JoseAvalos/JRO-/doc/trunk/ddsroot/docs/datasheets/mcu_k64f/FRDM-K64F.jpg

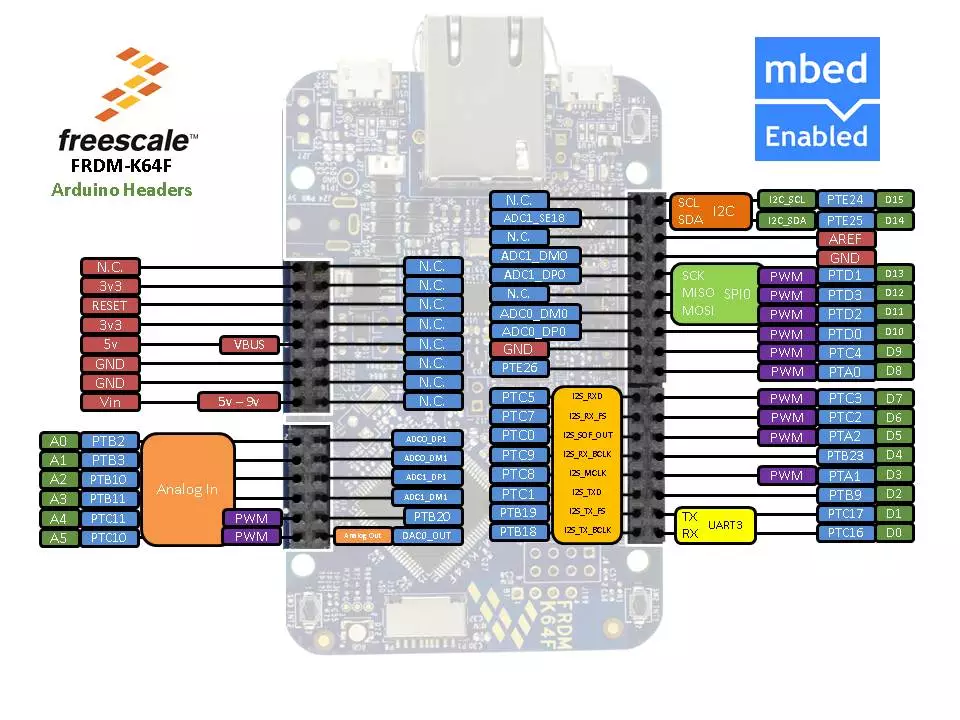
doc/trunk/ddsroot/docs/datasheets/mcu_k64f/FRDM-K64F.jpg
