JoseAvalos/JRO-/doc/trunk/ddsroot/source/schematics/dds_ad9854/README

JRO EVM AD9854

Esta tarjeta fue desarrollado en Jicamarca y esta basada integramente en la tarjeta de evaluacion 
del AD9854. El programa para su diseno fue Orcad (en el ano 2011)
