JoseAvalos/JRO-/doc/DDS_block_diagram.png

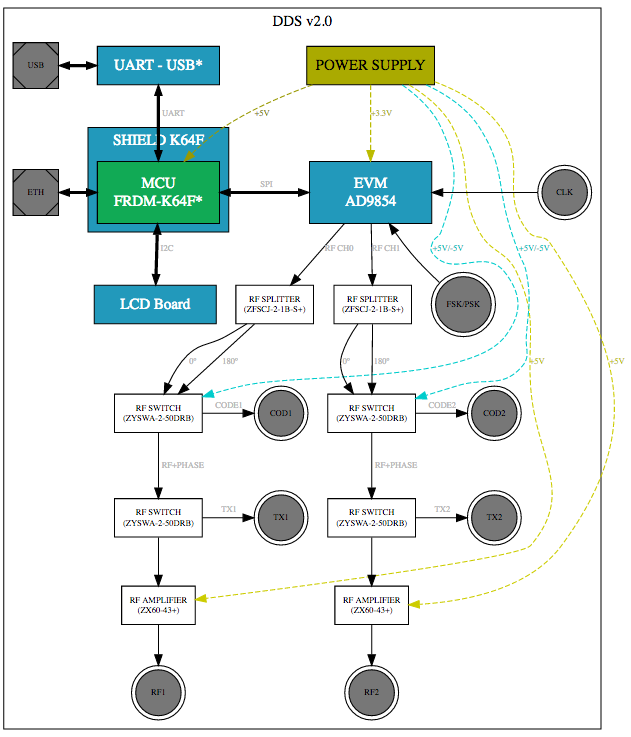
doc/DDS_block_diagram.png
