JoseAvalos/JRO-/doc/trunk/ddsroot/source/schematics/usb_serial/gerber/RC_USB1-BOM.txt

Item	Cantidad	Referencia	Descripción			Código
1	3		C1,C2,C3	Condensador 100nF, 0805		378
2	1		C4		Condensador 10uF, 3528		359
3	1		IC1		Circuito Integrado FT 232RL	807
4	1		X1		Conector USB tipo B		3168
5	1		X2		Header 2x5 para PCB, macho	1010
