JoseAvalos/JRO-/doc/trunk/ddsroot/source/schematics/dds_ad9854/gerber/DDS-BOM.xls

DDS 4 CAPAS
Item | Cantidad | Referencia | Descripción | Código Almacen | Donación
1 | 3 | C1,C2, C45 | Condensador 10nF, 50V, 1206 |  | PCF1308CT-ND | F
2 | 2 | C4, C37 | Condensador 27pF, 50V, 0805 | 385
3 | 2 | C5, C38 | Condensador 47pF, 50V, 0805 | 387
4 | 2 | C25, C6 | Condensador 10uF, 10V, 3528 | 359 |  | X
5 | 12 | C7, C9 ,C10, C11, C12, C13, C22, C23, C24, C27, C29, C44 | Condensador 0.1uF, 10V, 0402 | 354 |  | X
6 | 2 | C30, C39 | Condensador 39pF, 50V, 0805 | 386
7 | 2 | C31, C40 | Condensador 22pF, 50V, 0805 | 384
8 | 2 | C32, C41 | Condensador 2.2pF, 50V, 1206 | 382
9 | 2 | C33, C42 | Condensador 12pF, 50V, 0805 | 381
10 | 2 | C43, C34 | Condensador 8.2pF, 50V, 1206 | 388
11 | 5 | J1, J6, J7,J25, J26 | Conector SMA para PCB, 90°, 5mm | 953 |  | X
12 | 2 | J4, J5 | Conector SMA para PCB, 0°, 5mm |  | ACX1230-ND | X
13 | 1 | J10 | IDC header macho 2x20 PCB | 1008 |  | X
14 | 4 | L1, L2, L3, L5 | Inductancia 68 nH, 1008 | 1553 |  |  | X
15 | 2 | L6, L4 | Inductancia 82 nH, 1008 | 3457 |  |  | X
16 | 6 | R1, R5, R6, R11, R12, R13 | Resistencia de 49.9, 1206 | 2289 |  | X
17 | 2 | R20, R2 | Resistencia de 3.92K, 1206 | 2319 |  | X
18 | 2 | R3, R7 | Resistencia de 24.9, 0805 |  | PAT25.0BCT-ND | X
19 | 1 | R4 | Resistencia de 1.3K, 1206 |  | P1.30KFCT-ND | X
20 | 1 | R8 | Resistencia de 2K, 1206 | 2316 |  | X
21 | 2 | R10, R9 | Resistencia de 100, 1206 | 2293 |  | X
22 | 2 | R19, R14 | Resistencia de 0 ohmios, 0603 | 3579 |  | X
23 | 2 | TB1 | Bornera PCB 2 pines | 148 |  | X
24 | 1 | U1 | Circuito integrado AD9854AST | 705 |  | X
25 | 1 | U3 | Circuito Integrado MC100LVEL | 473 |  |  | X
26 | 5 | W1, W2, W3, W4, W8 | Espadín 3 pines | 996 |  | X
27 | 2 | W6, W16 | Espadín 2 pines | 996 |  | X
28 | 1 |  | Disipador de temperatura 15mm x 15mm x 9mm | 3583 |  | X
