JoseAvalos/JRO-/test/log10.png

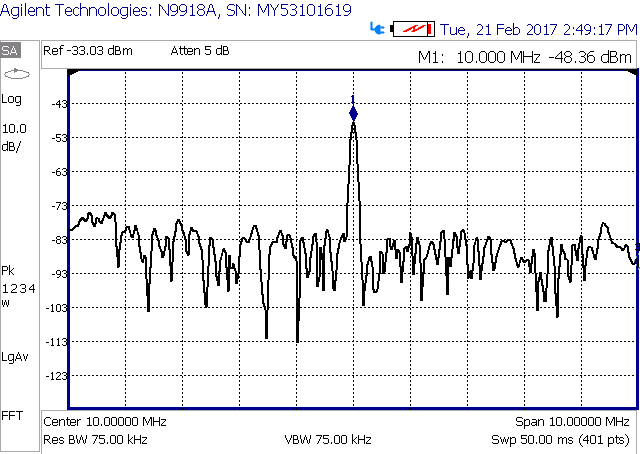
test/log10.png
