JoseAvalos/JRO-/test/log20.png

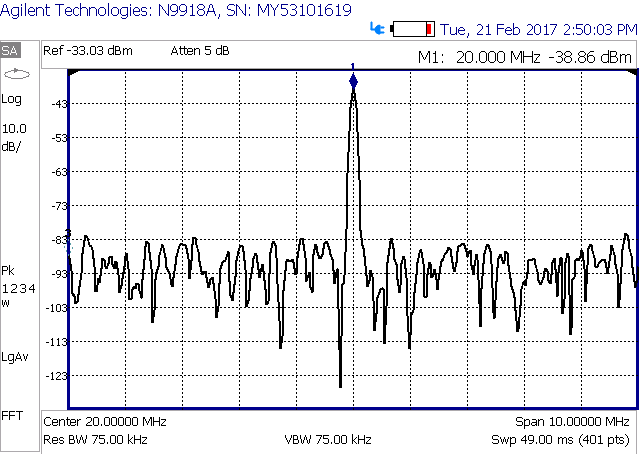
test/log20.png
