JoseAvalos/JRO-/test/log30.png

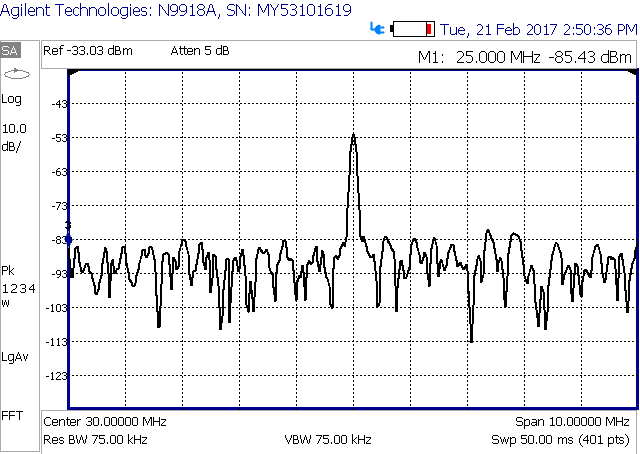
test/log30.png
