JoseAvalos/JRO-/test/log40.png

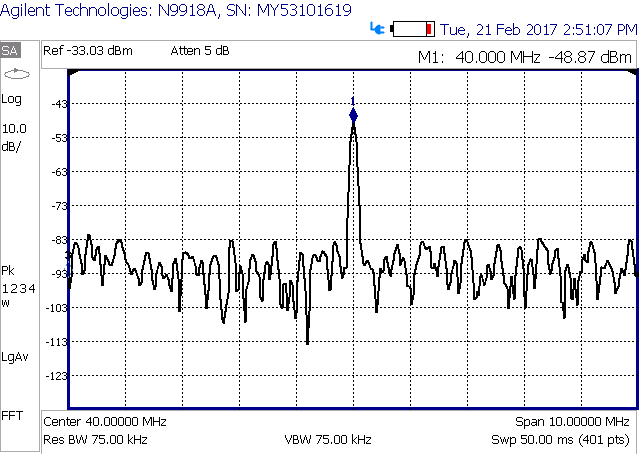
test/log40.png
