JoseAvalos/JRO-/test/log49.920.png

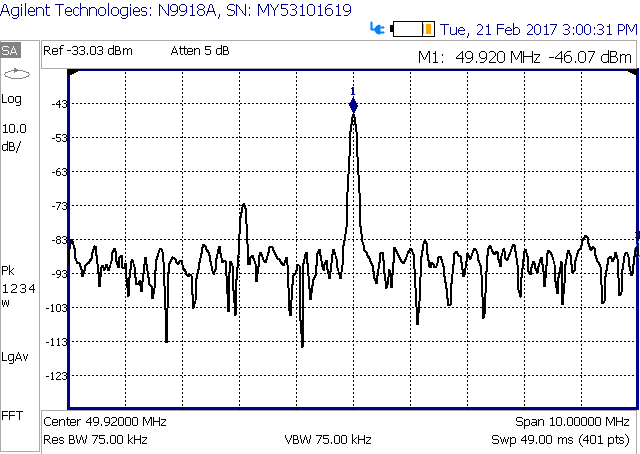
test/log49.920.png
