JoseAvalos/JRO-/test/log50.png

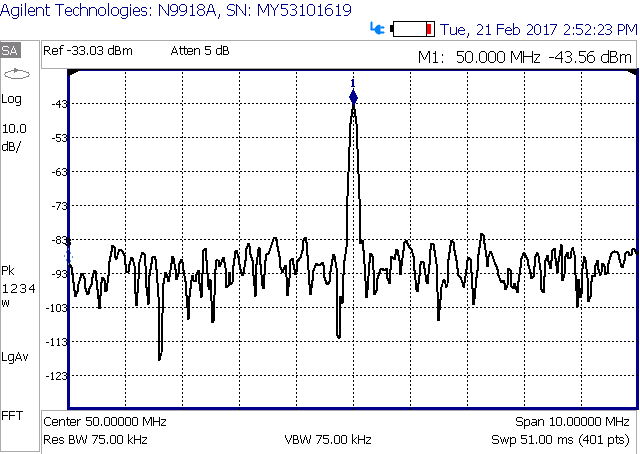
test/log50.png
