JoseAvalos/JRO-/test/log60.png

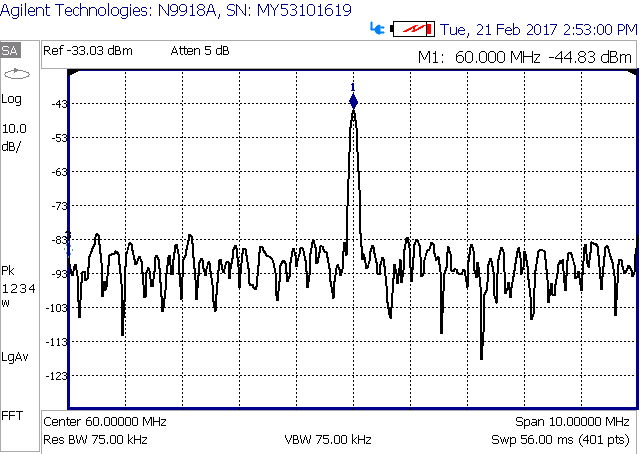
test/log60.png
