JoseAvalos/JRO-/test/log70.png

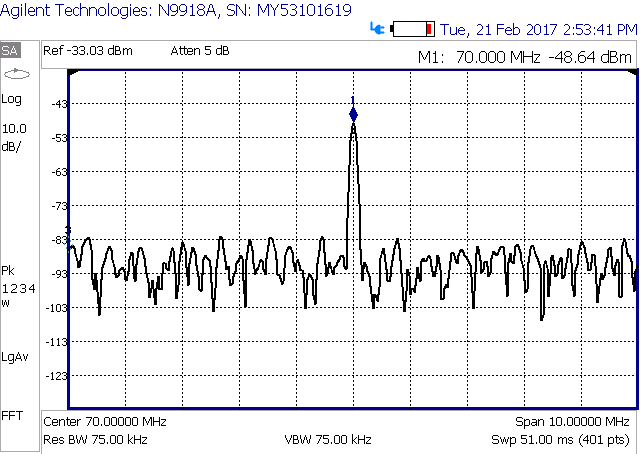
test/log70.png
