JoseAvalos/JRO-/test/log90.png

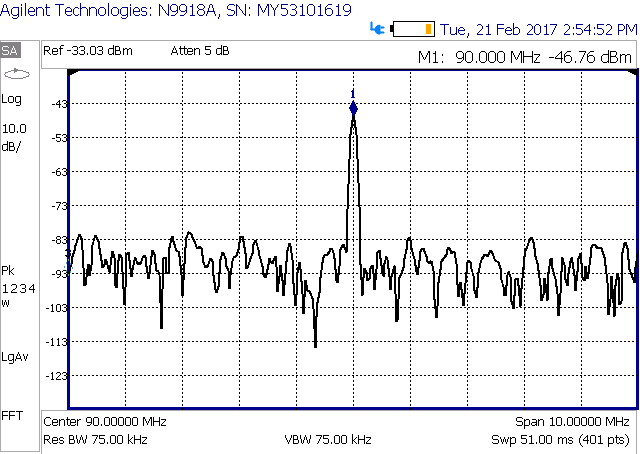
test/log90.png
