JoseAvalos/JRO-/test/log100.png

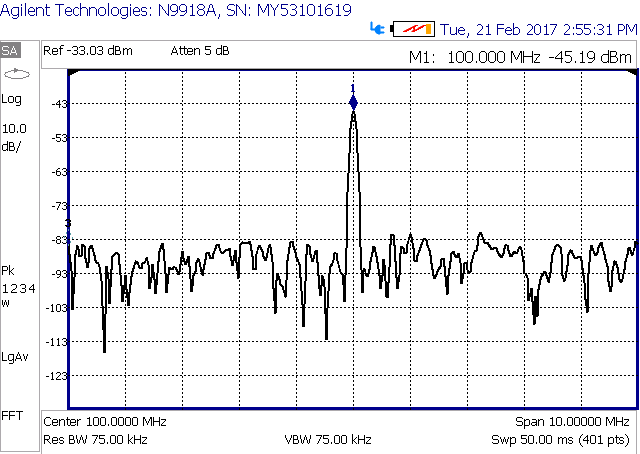
test/log100.png
