JoseAvalos/JRO-/test/log110.png

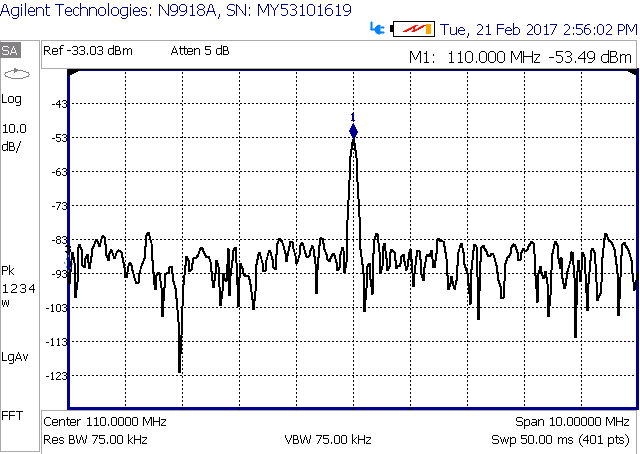
test/log110.png
