JoseAvalos/JRO-/test/log120.png

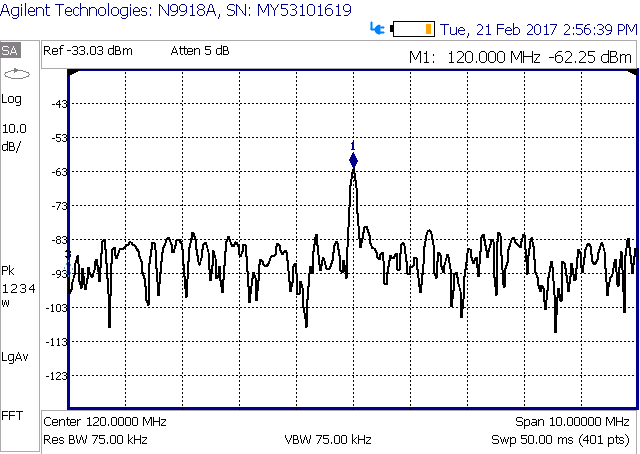
test/log120.png
