JoseAvalos/JRO-/doc/trunk/ddsroot/source/schematics/dds_ad9854/DDS0-SCH.pdf

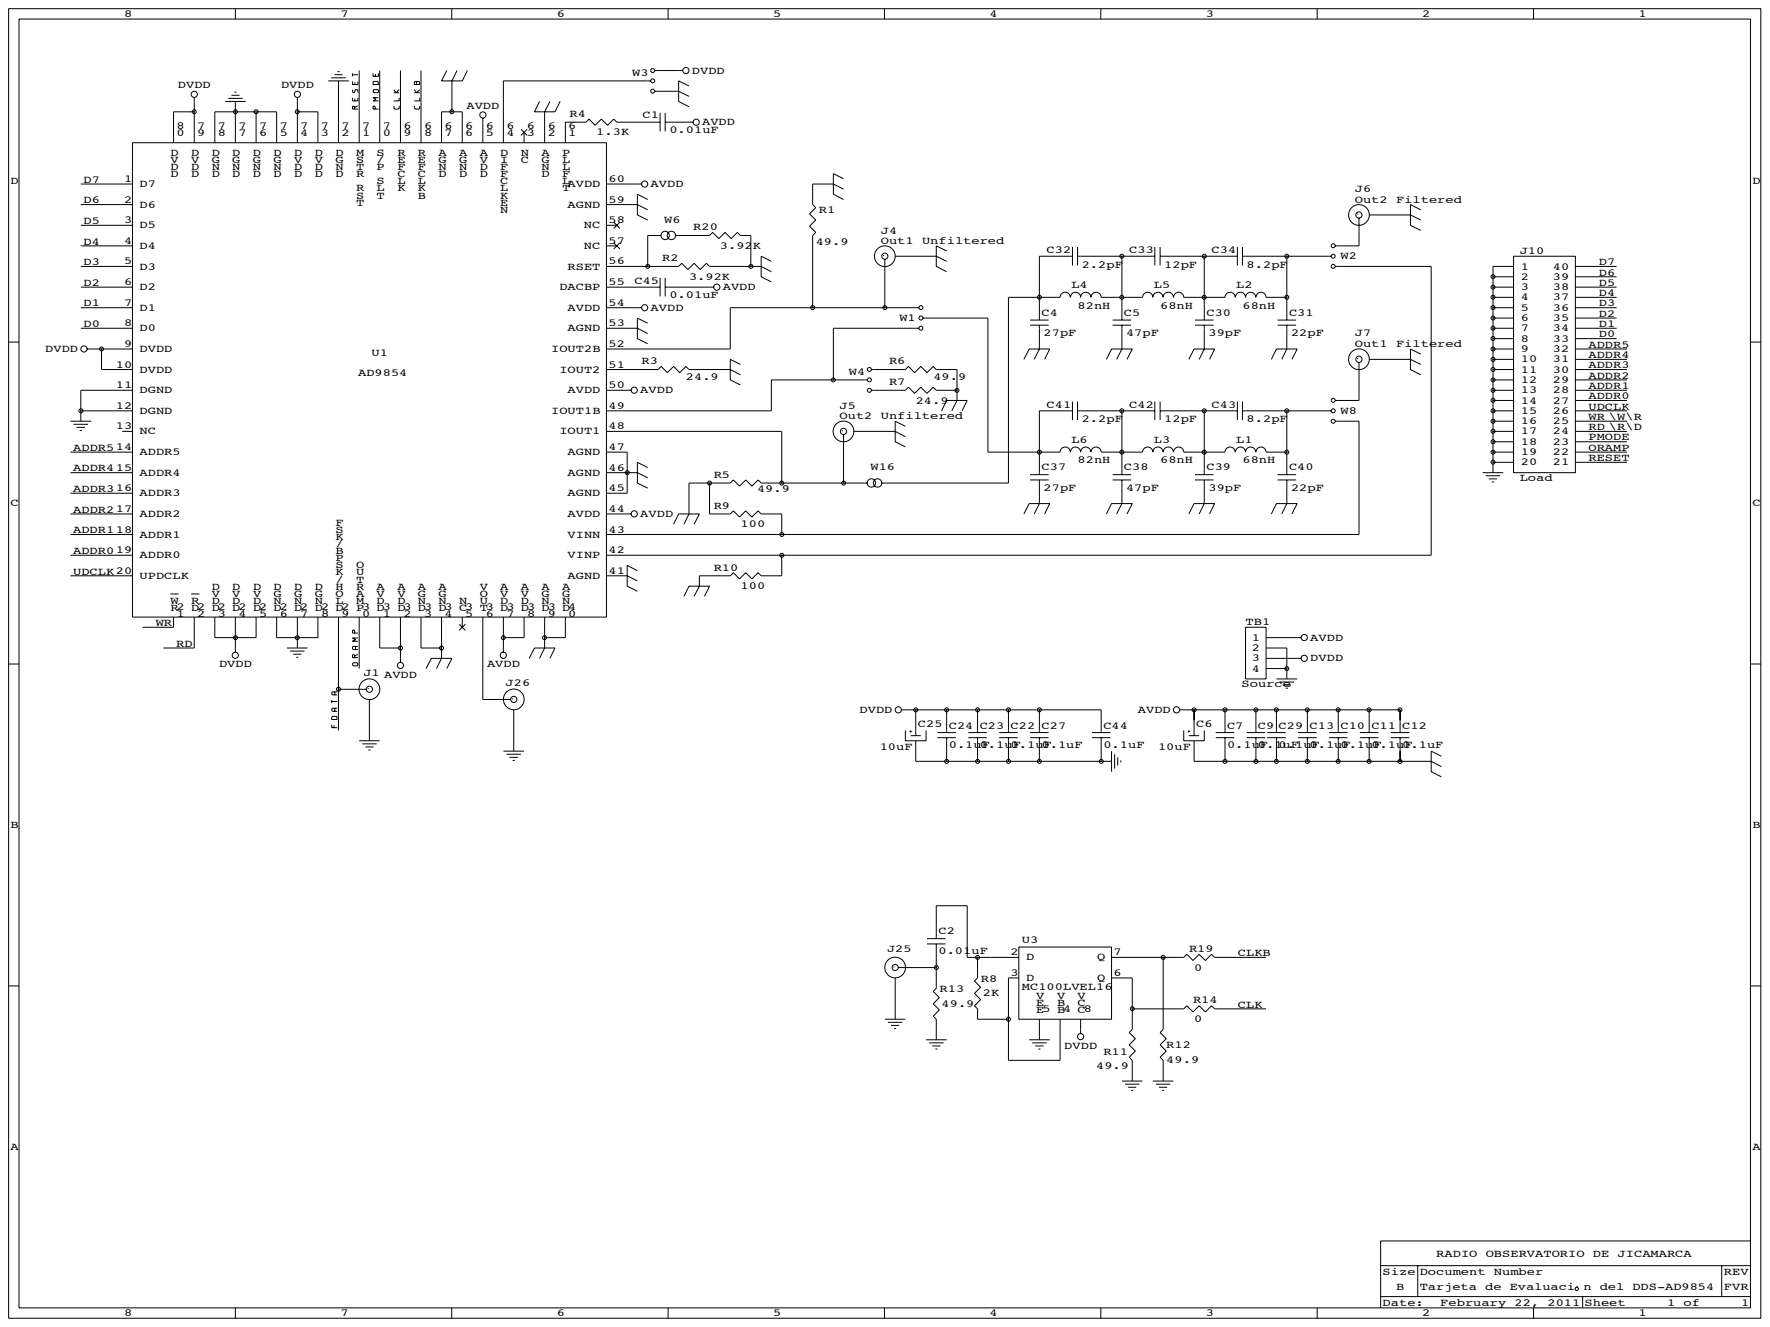
[picture p15: page 1]

RADIO OBSERVATORIO DE JICAMARCA
