JoseAvalos/JRO-/doc/trunk/ddsroot/source/schematics/shield_mcu_dds/SHIELD_MCU_DDS_1_3.brd

## EAGLE design doc/trunk/ddsroot/source/schematics/shield_mcu_dds/SHIELD_MCU_DDS_1_3.brd (2017-03-01)

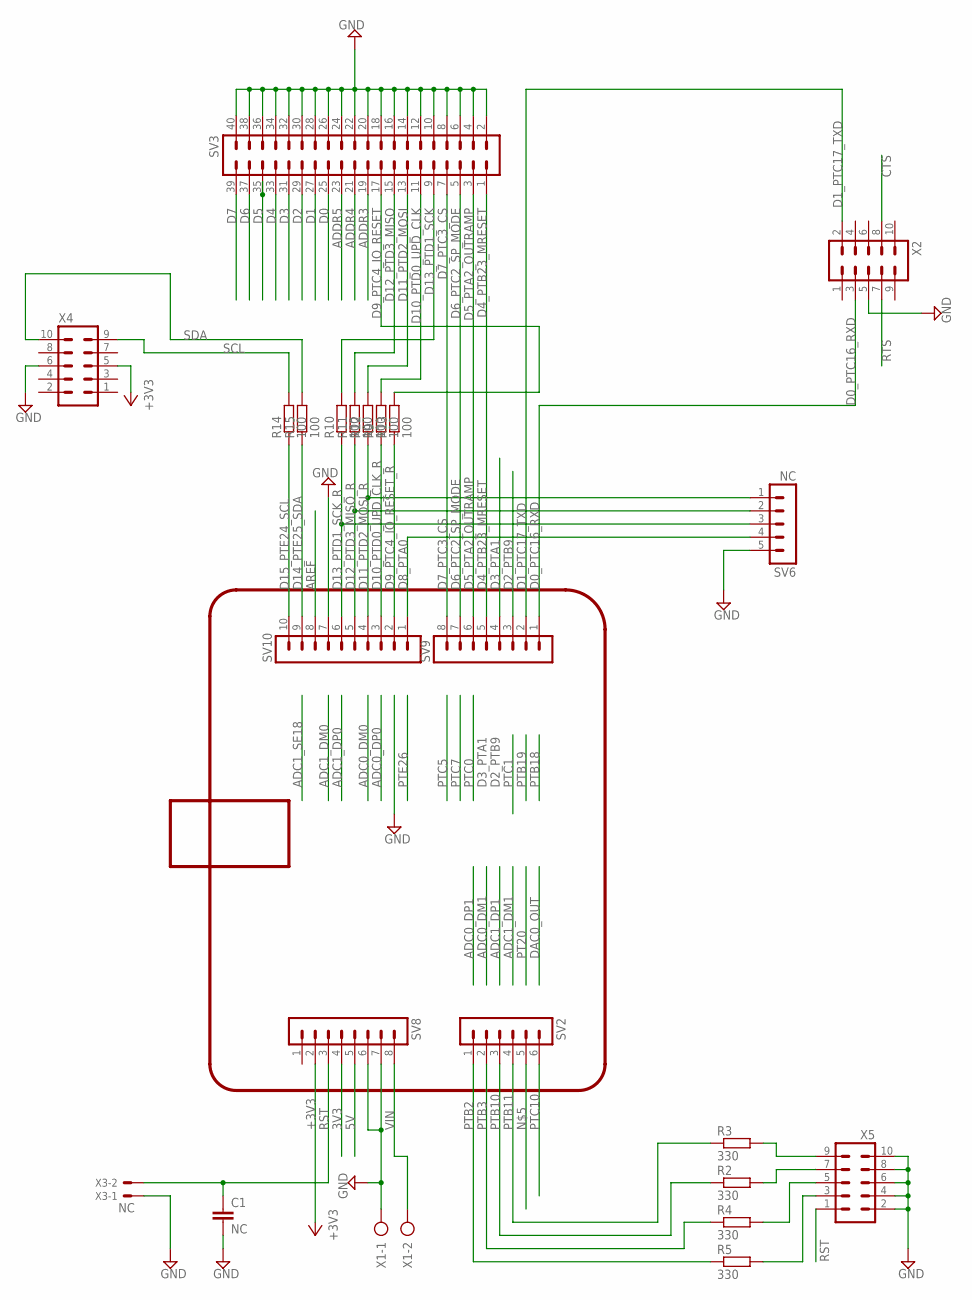
[picture p16: schematic SHIELD_MCU_DDS_1_3.sch]

Parts:
C1: NC; C1206
R2, R3, R4, R5: 330; R0603
R9, R10, R11, R12, R13, R14, R15: 100; 0204/7
SV2: MA06-1
SV3: ML40
SV6: NC; MA05-1
SV8, SV9: MA08-1
SV10: MA10-1
X1: AK300/2
X2, X4, X5: ML10
X3: NC; 22-23-2021

Connections:
3V3: SV8.4
5V: SV8.5
+3V3: SV8.2, X4.5
ADDR3: SV3.19
ADDR4: SV3.21
ADDR5: SV3.23
AREF: SV10.8
CTS: X2.8
D0: SV3.25
D0_PTC16_RXD: SV9.1, X2.3
D1: SV3.27
D1_PTC17_TXD: SV9.2, X2.2
D2: SV3.29
D2_PTB9: SV9.3
D3: SV3.31
D3_PTA1: SV9.4
D4: SV3.33
D4_PTB23_MRESET: SV3.1, SV9.5
D5: SV3.35
D5_PTA2_OUTRAMP: SV3.3, SV9.6
D6: SV3.37
D6_PTC2_SP_MODE: SV3.5, SV9.7
D7: SV3.39
D7_PTC3_CS: SV3.7, SV9.8
D8_PTA0: SV6.4, SV10.1
D9_PTC4_IO_RESET: R13.2, SV3.17
D9_PTC4_IO_RESET_R: R13.1, SV10.2
D10_PTD0_UPD_CLK: R9.2, SV3.11
D10_PTD0_UPD_CLK_R: R9.1, SV10.3
D11_PTD2_MOSI: R12.2, SV3.13
D11_PTD2_MOSI_R: R12.1, SV6.1, SV10.4
D12_PTD3_MISO: R11.2, SV3.15
D12_PTD3_MISO_R: R11.1, SV6.2, SV10.5
D13_PTD1_SCK: R10.2, SV3.9
D13_PTD1_SCK_R: R10.1, SV6.3, SV10.6
D14_PTE25_SDA: R15.1, SV10.9
D15_PTE24_SCL: R14.1, SV10.10
GND: C1.2, SV3.2, SV3.4, SV3.6, SV3.8, SV3.10, SV3.12, SV3.14, SV3.16, SV3.18, SV3.20, SV3.22, SV3.24, SV3.26, SV3.28, SV3.30, SV3.32, SV3.34, SV3.36, SV3.38, SV3.40, SV6.5, SV8.6, SV8.7, SV10.7, X1.1, X2.5, X3.1, X4.6, X5.2, X5.4, X5.6, X5.8, X5.10
unnamed: R2.2, X5.7
unnamed: R4.2, X5.5
unnamed: R5.2, X5.3
unnamed: R3.2, X5.9
PTB2: R5.1, SV2.1
PTB3: R4.1, SV2.2
PTB10: R2.1, SV2.3
PTB11: R3.1, SV2.4
PTC10: SV2.6
RST: C1.1, SV8.3, X3.2, X5.1
RTS: X2.7
SCL: R14.2, X4.9
SDA: R15.2, X4.10
VIN: SV8.8, X1.2

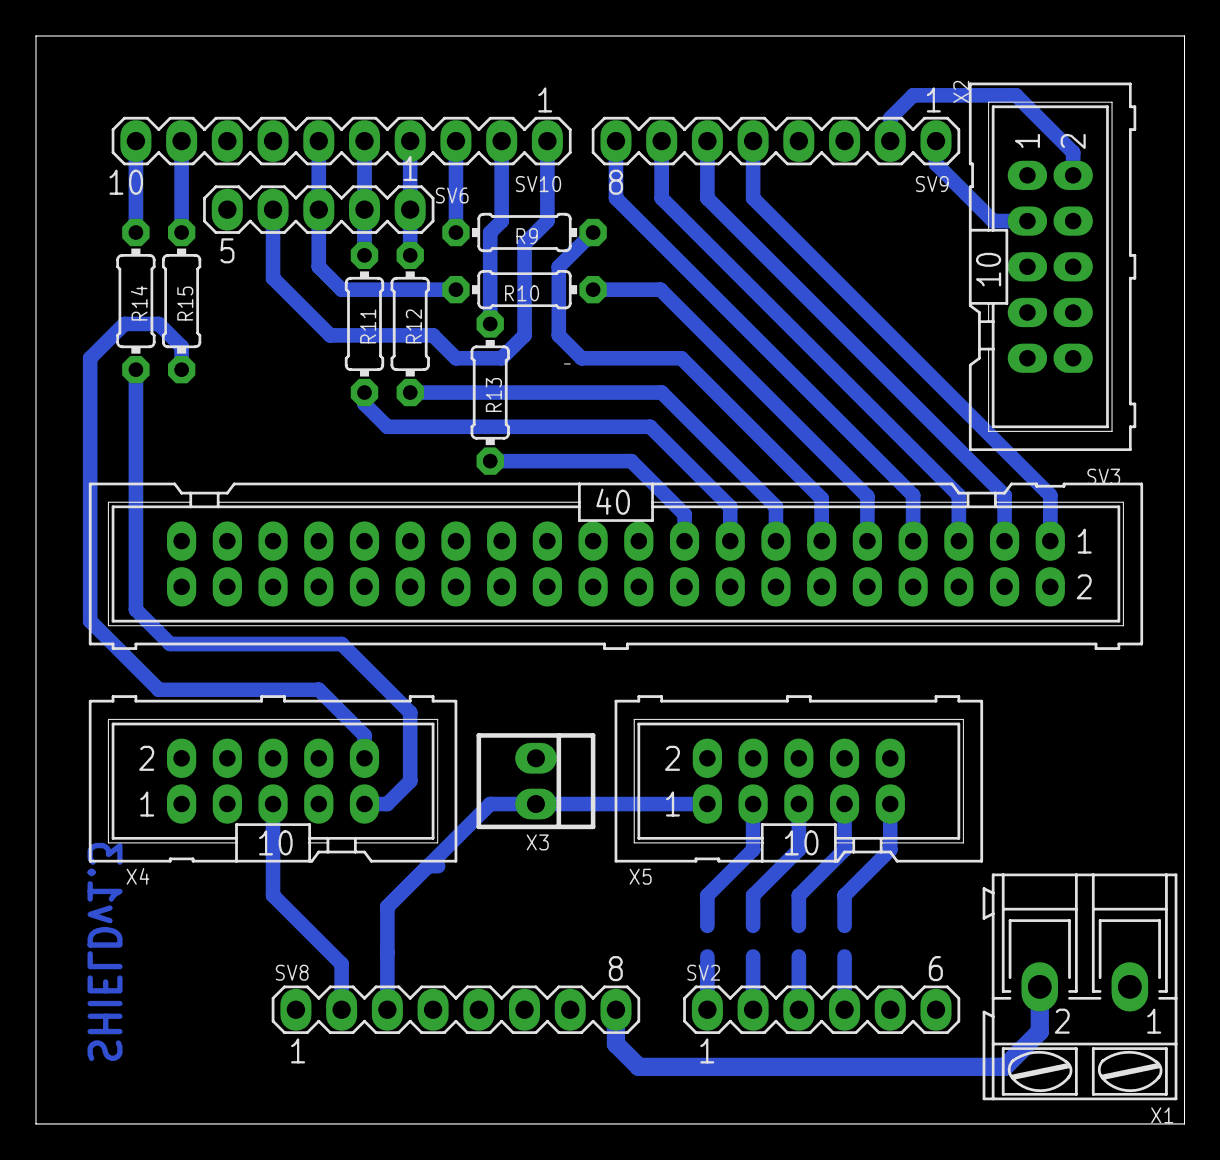
[picture p17: board SHIELD_MCU_DDS_1_3.brd from above]

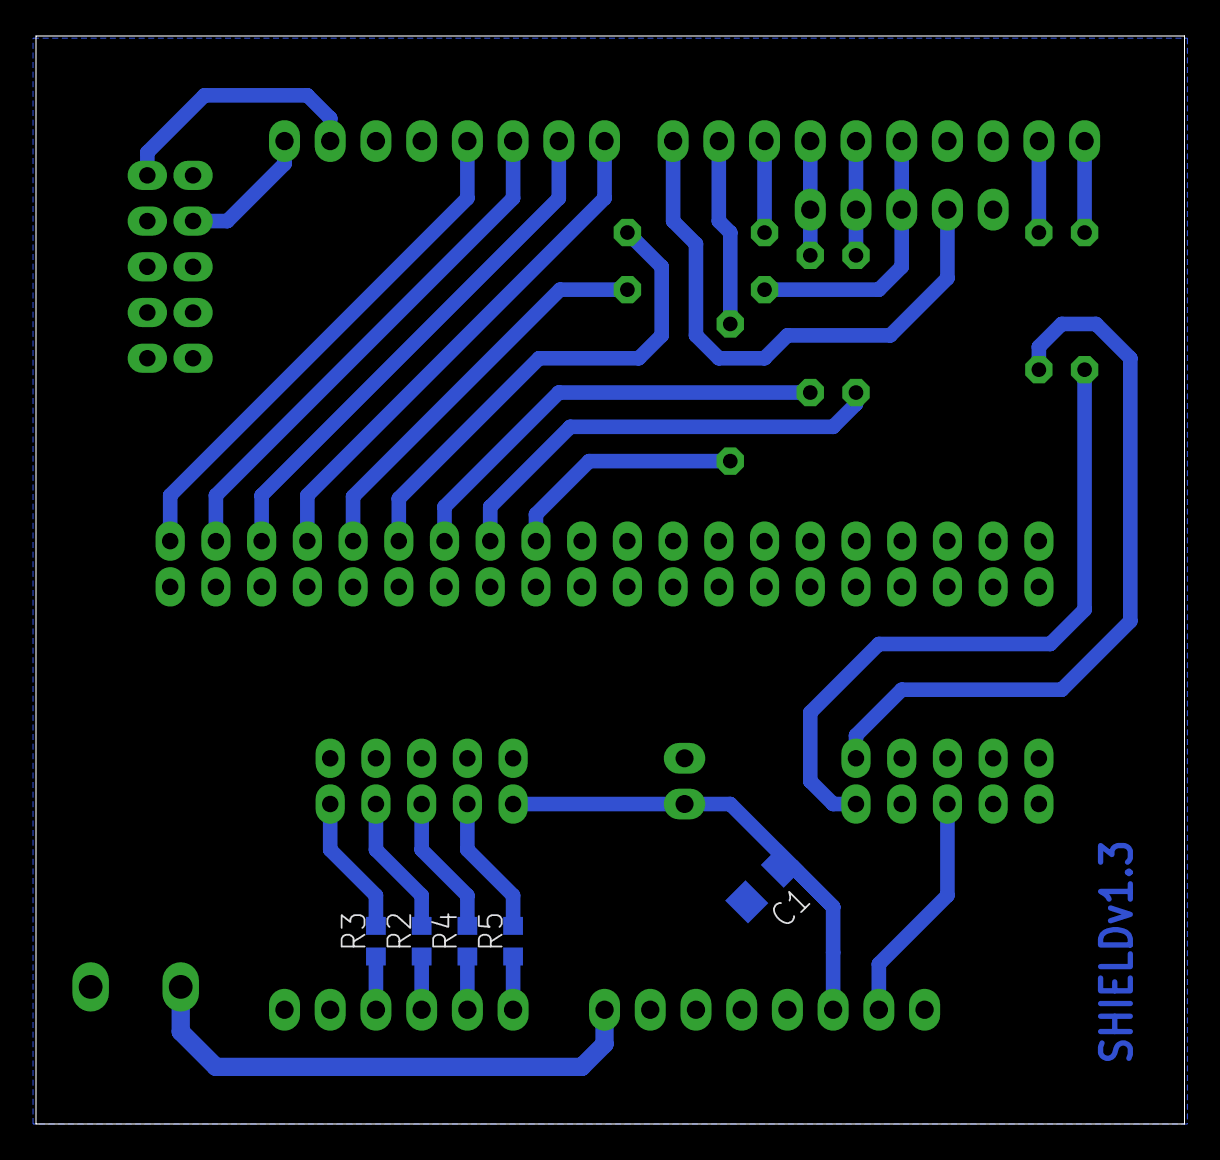
[picture p18: board SHIELD_MCU_DDS_1_3.brd from below]

Board: 2 copper layers, 63.8 x 60.4 mm, 24 parts (5 on the bottom side), 33 nets.

Other parts of the board:
U$1: JICA_LOGO1
