JoseAvalos/JRO-/doc/trunk/ddsroot/source/schematics/lcd_interface/interfaz_LCD.brd

## EAGLE design doc/trunk/ddsroot/source/schematics/lcd_interface/interfaz_LCD.brd (2017-03-01)

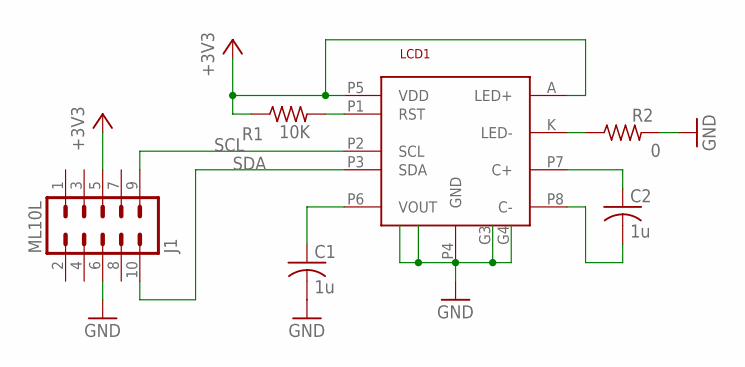
[picture p19: schematic interfaz_LCD.sch]

Parts:
C1, C2: 1u; C1206
J1: ML10L
LCD1: NHDC0220; LCD_NHD
R1: 10K; R1206
R2: 0; R1206

Connections:
+3V3: J1.5, LCD1.A (LED+), LCD1.P5 (VDD), R1.1
GND: C1.2, J1.6, LCD1.G1, LCD1.G2, LCD1.G3, LCD1.G4, LCD1.P4 (GND), R2.2
unnamed: LCD1.P1 (RST), R1.2
unnamed: LCD1.K (LED-), R2.1
unnamed: C1.1, LCD1.P6 (VOUT)
unnamed: C2.1, LCD1.P7 (C+)
unnamed: C2.2, LCD1.P8 (C-)
SCL: J1.9, LCD1.P2 (SCL)
SDA: J1.10, LCD1.P3 (SDA)

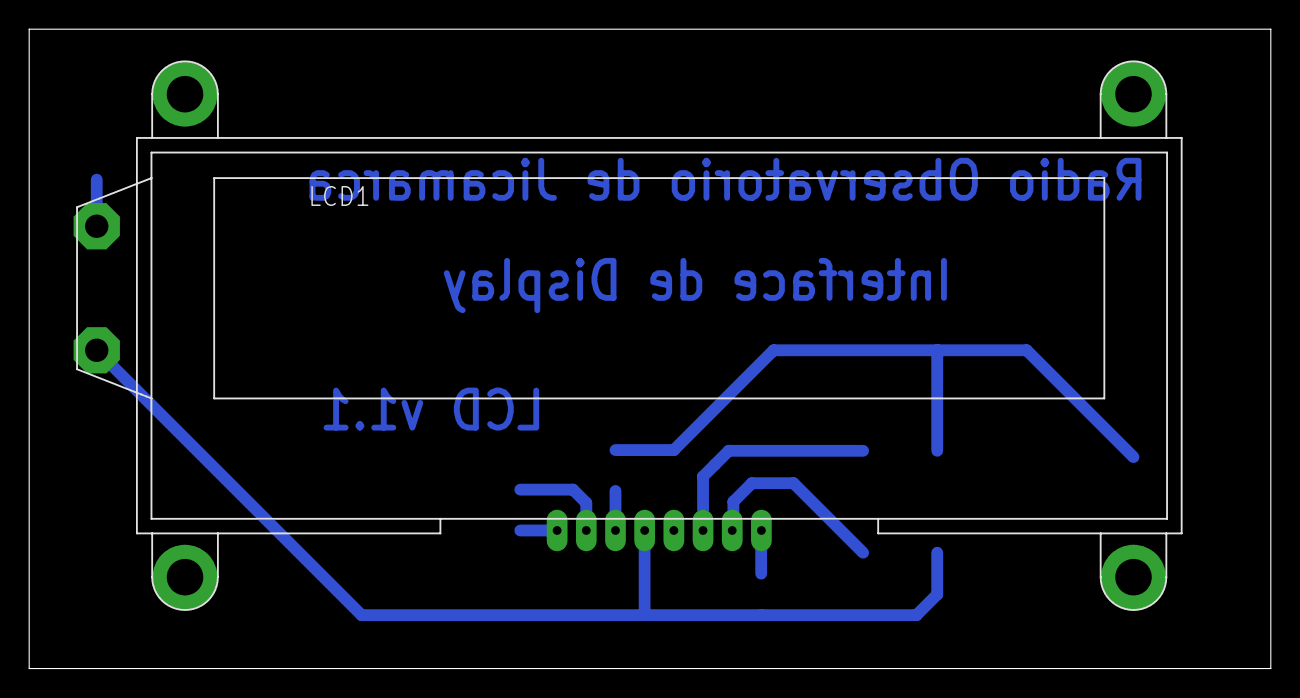
[picture p20: board interfaz_LCD.brd from above]

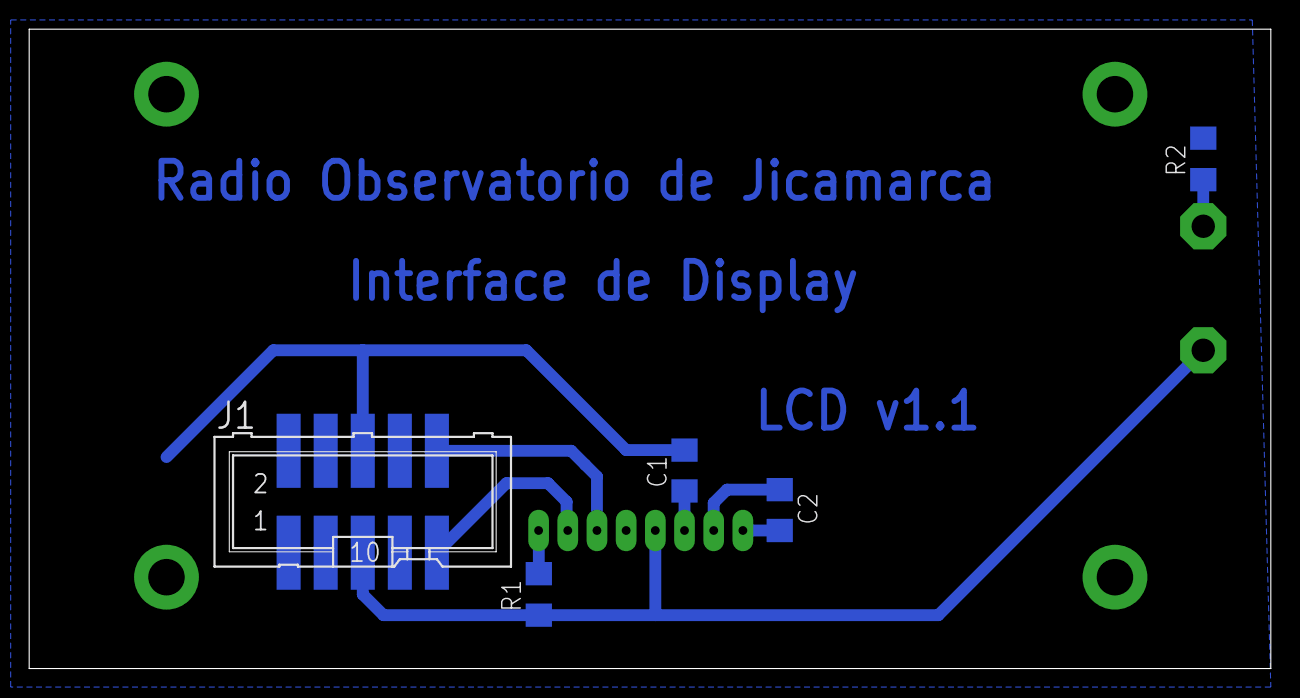
[picture p21: board interfaz_LCD.brd from below]

Board: 2 copper layers, 85.1 x 43.8 mm, 6 parts (5 on the bottom side), 9 nets.
