JoseAvalos/JRO-/(commit log)

2017-01-30 add api-spi-webser files
2017-02-08 prove with previous version failes
    [SPI.ino]
2017-02-14 insert new library
2017-03-01 add doc
    [DDS-BOM.xls, DDS0.BRD, DDS0.SCH, RC_USB1.brd, RC_USB1.sch, SHIELD_MCU_DDS_1_3.brd, SHIELD_MCU_DDS_1_3.sch, interfaz_LCD.brd]
